aep/artanis-light/README.md

vehicle gps tracker with battery
================================

- cpu:     ESP32
- modem:   Quectel BG96 minipcie
- supply:  ~12V from vehicle
- battery: 2 14500 lifepo cells at 6.4V
