aep/artanis-light/basic.ods

Id | Designator | Package | Quantity | Designation | Supplier and ref | Stocked/Ordered
17 | C | C_0603_1608Metric | 2 | 0.1uF |  | S
24 | C | C_0402_1005Metric | 1 | 0.5pF. NP0, ±10 % |  | O
23 | C | C_0402_1005Metric | 1 | 0.8pF, NP0, ±10 % |  | O
50 | C | 603 | 1 | 100nF |  | S
11 | C | 603 | 5 | 100nF 50V |  | S
30 | C | C_0603_1608Metric | 4 | 100nF, X7R, ±10 % |  | S
31 | C | C_0603_1608Metric | 1 | 100pF, NP0, ±5 % |  | O
4 | C | CP_Elec_6.3x7.7 | 2 | 100uF 50V |  | S
29 | C | C_0603_1608Metric | 2 | 1.0uF, X7R, ±10 % |  | S
16 | C | 603 | 2 | 12pF, NP0, ±2% |  | S
53 | C | 603 | 1 | 2.2uF 50V |  | S
51 | C | 603 | 3 | 33pF |  | O
52 | C | C_0603_1608Metric | 2 | 33pf |  | O
37 | C | C_0603_1608Metric | 1 | 4.7uF |  | S
5 | C | 603 | 2 | 4.7uF 50V |  | S
32 | C | C_0603_1608Metric | 1 | 4.7uF, X7R, ±10 % |  | S
33 | C | C_0603_1608Metric | 4 | 56pf |  | O
28 | C | C_0603_1608Metric | 1 | 820pF, NP0, ±5 % |  | O
22 | C | C_0603_1608Metric | 2 | NC |  | /
25 | C | C_0402_1005Metric | 1 | NC |  | /
2 | CON1 | MM60-52B1-G1-R850 | 1 | MSATA-PCIE_MINI-CARD-MM60-52B1-G1-R850(Digi-Key_PN_670-2516-2-ND) |  | S
15 | D1 | LED_0603_1608Metric | 1 | APGA1602QBC/KA-5MAV |  | o
40 | D2 | D_SMB | 1 | SMBJ16CA-13-F |  | S
56 | D3 | SOT-23 | 1 | SZNUP2105L |  | S
14 | D4 | LED_0603_1608Metric | 1 | APGA1602CGC/KA |  | o
41 | EXT_ANT2,EXT_ANT1,EXT_ANT6 | SMA_Amphenol_132203-12_Horizontal | 3 | SMA_F_R_A_PCB |  | o
60 | EXT_ANT4,EXT_ANT3 | U.FL_Molex_MCRF_73412-0110_Vertical | 2 | SMA_F_R_A_PCB |  | S
38 | F1,F2 | Fuse_1206_3216Metric | 2 | Fuse |  | S
54 | FID2,FID1 | FIDUCIAL-1X2 | 2 | Fiducial |  | /
39 | FL1 | ACM70V | 1 | ACM70V-701-2PL-TL00 |  | S
49 | J1 | TC2030-MCP-NL | 1 | SWD |  | /
59 | J2 | nanosim-Wurth-693043020611 | 1 | simcard |  | S
3 | J3 | DF65-3P-1.7V | 1 | Conn_01x03_Male |  | O
44 | J5 | Molex_Micro-Fit_3.0_43045-0400_2x02_P3.00mm_Horizontal | 1 | Conn_02x02_Top_Bottom |  | o
27 | L1 | L_0402_1005Metric | 1 | 4.7nH ±5 % |  | o
42 | L2 | PE-1210ACC | 1 | PE-1210ACC110STS 11UH |  | S
6 | L3 | L_Coilcraft_XxL4020 | 1 | 2.2uH |  | o
19 | Q2 | SOT23-3 | 1 | PMV30XPEAR |  | o
21 | Q4 | SOT-23 | 1 | DMP3099L-7 |  | o
20 | R11 | R_0603_1608Metric | 1 | 10K |  | S
9 | R12 | 603 | 1 | 10K |  | S
8 | R14,R13 | 603 | 2 | 1K |  | S
35 | R24 | 603 | 1 | 16K + 22K + 5K |  | o
48 | R25 | 603 | 1 | 3k6 |  | S
58 | R3 | R_0603_1608Metric | 1 | 1K-10K |  | S
57 | R4,R1 | 603 | 2 | 3k6 |  | S
36 | R7,R6,R5 | 603 | 3 | 45 |  | S
13 | R8,R2,R10 | R_0603_1608Metric | 3 | 1K |  | S
10 | R9 | 603 | 1 | 33K2 1% |  | o
47 | TP2 | TP_SMD | 1 | L0 |  | /
46 | TP3 | TP_SMD | 1 | L1 |  | /
45 | TP4 | TP_SMD | 1 | L3 |  | /
18 | U1 | Nordic_AQFN-73-1EP_7x7mm_P0.5mm | 1 | nRF52840 |  | o
55 | U2 | QFN-20-1EP_4x4mm_P0.5mm_EP2.5x2.5mm_ThermalVias | 1 | MCP2515-QFN |  | S
7 | U3 | DFN-10-1EP_3x3mm_P0.5mm_EP1.55x2.48mm | 1 | MCP73223-C2S |  | o
43 | U4 | SOT-23-8 | 1 | TCAN332 |  | S
12 | U5 | SOT-23-6 | 1 | TPS565201DDC |  | o
1 | U7 | QFN-16 | 1 | MMA8452Q |  | S
26 | Y1 | Crystal_SMD_Abracon_ABM8G-4Pin_3.2x2.5mm | 1 | / |  | o
34 | Y2 | Crystal_SMD_Abracon_ABM8G-4Pin_3.2x2.5mm | 1 | M8AIG-16-12-2T3 |  | S
 |  |  |  | bg96
 |  |  |  | case
 |  |  |  | sma2sma
