aep/artanis-light/Model/battery_holder.step

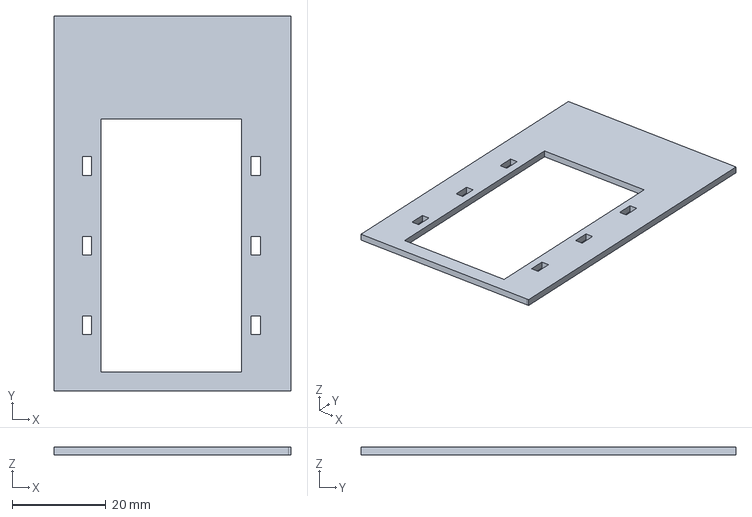
[picture p1: CAD file, 2021-03-20]
Model/battery_holder.step
50.5 x 80.0 x 1.60 mm
