aep/artanis-light/specs/Enclosure_AL-053-10.pdf

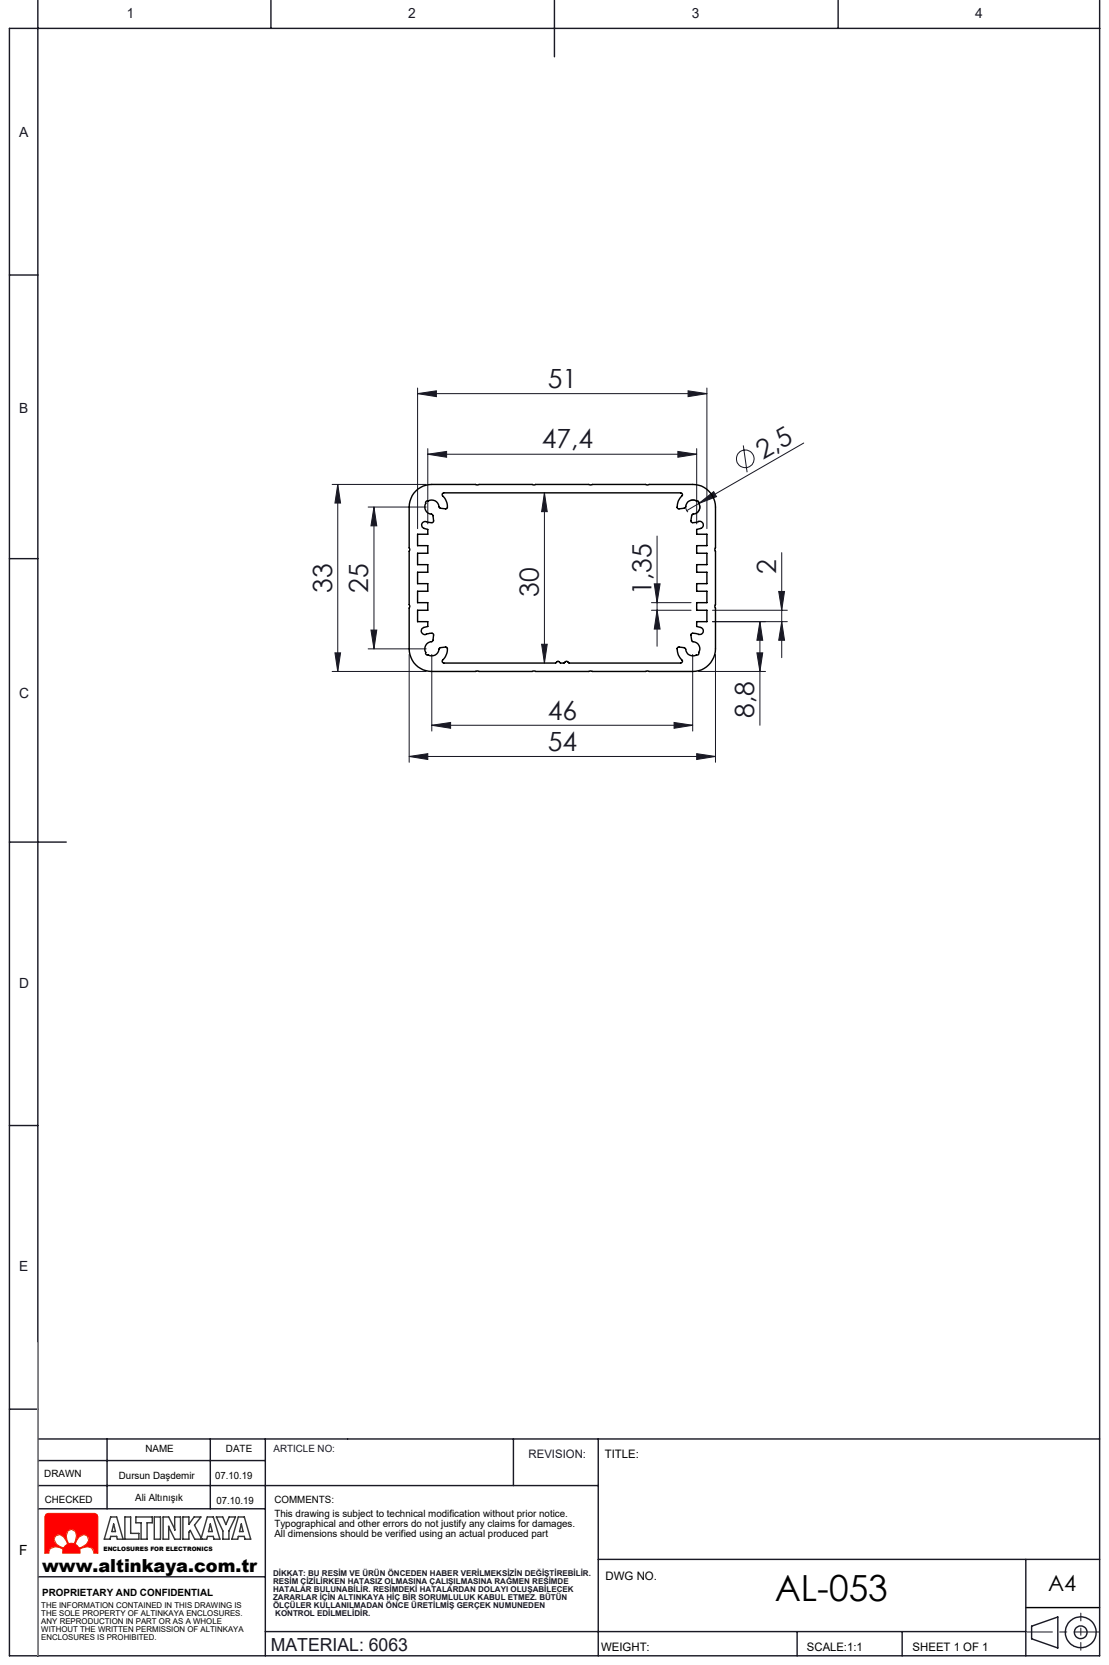
[picture p2: page 1]
SCALE:1:1; SHEET 1 OF 1; DWG NO.; Ali Altınışık; Dursun Daşdemir; NAME; DATE; ARTICLE NO:; REVISION:

This drawing is subject to technical modification without prior notice.
Typographical and other errors do not justify any claims for damages.
All dimensions should be verified using an actual produced part

www.altinkaya.com.tr

ENCLOSURES FOR ELECTRONICS

DİKKAT: BU RESİM VE ÜRÜN ÖNCEDEN HABER VERİLMEKSİZİN DEĞİŞTİREBİLİR.
RESİM ÇİZİLİRKEN HATASIZ OLMASINA ÇALIŞILMASINA RAĞMEN RESİMDE
HATALAR BULUNABİLİR. RESİMDEKİ HATALARDAN DOLAYI OLUŞABİLECEK
ZARARLAR İÇİN ALTINKAYA HİÇ BİR SORUMLULUK KABUL ETMEZ. BÜTÜN
ÖLÇÜLER KULLANILMADAN ÖNCE ÜRETİLMİŞ GERÇEK NUMUNEDEN
KONTROL EDİLMELİDİR.
MATERIAL: 6063

PROPRIETARY AND CONFIDENTIAL
THE INFORMATION CONTAINED IN THIS DRAWING IS
THE SOLE PROPERTY OF ALTINKAYA ENCLOSURES.
ANY REPRODUCTION IN PART OR AS A WHOLE
WITHOUT THE WRITTEN PERMISSION OF ALTINKAYA
ENCLOSURES IS PROHIBITED.
