aep/artanis-light/basic.kicad_pcb

## KiCad design basic.kicad_pcb (2021-03-20)

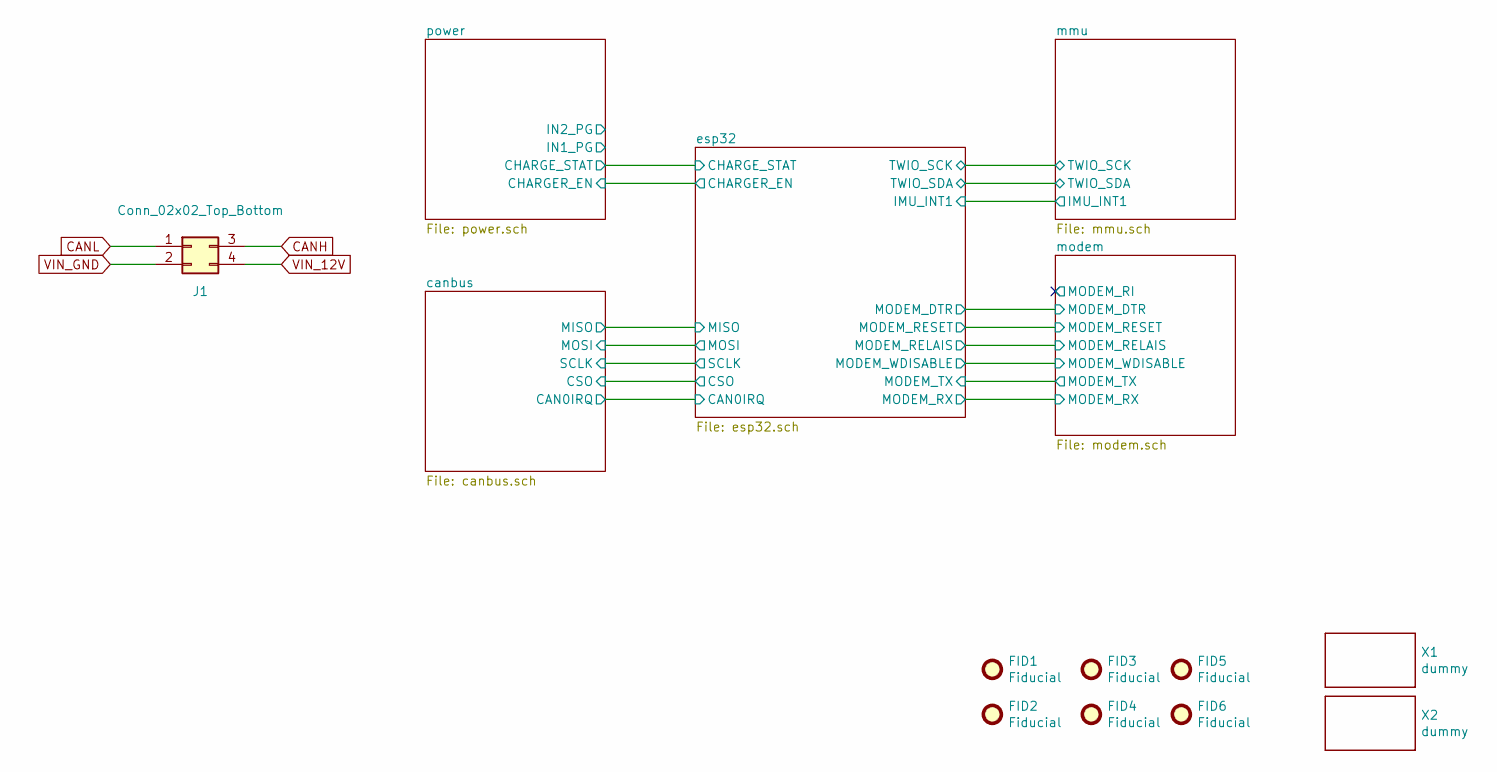
[picture p3: schematic basic.sch]

Parts:
FID1, FID2, FID3, FID4, FID5, FID6: Fiducial; FIDUCIAL-1X2
J1: Conn_02x02_Top_Bottom; Molex_Micro-Fit_3.0_43045-0400_2x02_P3.00mm_Horizontal
X1: dummy; WEEE-Logo_2.1x3mm_SilkScreen
X2: dummy; OSHW-LOGO-S

Connections:
CANH: J1.3; also elsewhere on the board
CANL: J1.1; also elsewhere on the board
VIN_12V: J1.4; also elsewhere on the board
VIN_GND: J1.2; also elsewhere on the board

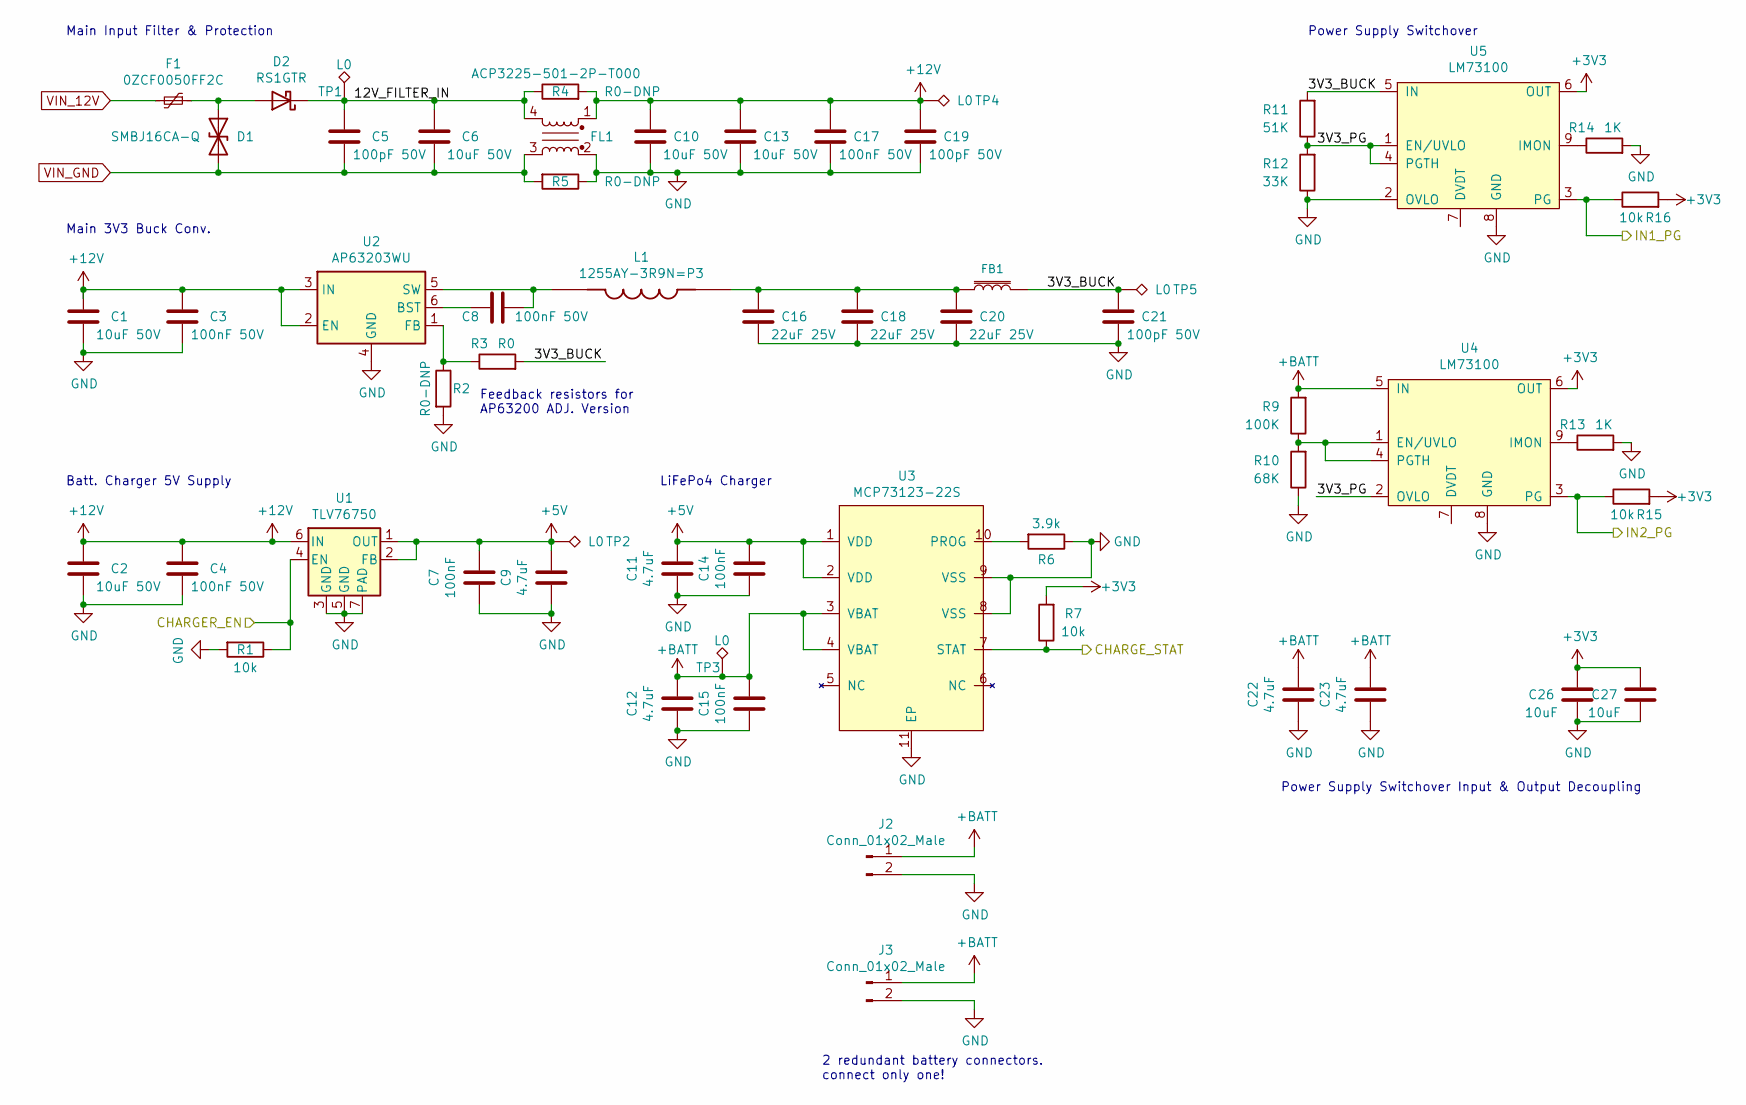
[picture p4: schematic power.sch]

Parts:
C1, C2, C6, C10, C13: 10uF 50V; C_0805_2012Metric
C3, C4, C8, C17: 100nF 50V; C_0603_1608Metric
C5, C19, C21: 100pF 50V; C_0603_1608Metric
C7, C14, C15: 100nF; C_0603_1608Metric
C9, C11, C12, C22, C23: 4.7uF; C_0603_1608Metric
C16, C18, C20: 22uF 25V; C_0805_2012Metric
C26, C27: 10uF; C_0603_1608Metric
D1: SMBJ16CA-Q; D_SMB
D2: RS1GTR; D_SMA
F1: 0ZCF0050FF2C; Fuse_2920_7451Metric_Castellated
FB1: BLM18PG181SN1D; 0603
FL1: ACP3225-501-2P-T000; ACP3225
J2: Conn_01x02_Male; JST_SH_BM02B-SRSS-TB_1x02-1MP_P1.00mm_Vertical
J3: Conn_01x02_Male; JST_SH_SM02B-SRSS-TB_1x02-1MP_P1.00mm_Horizontal
L1: 1255AY-3R9N=P3; IND_1255AY-3R9N=P3
R1, R7, R15, R16: 10k; R_0603_1608Metric
R2, R4, R5: R0-DNP; R_0603_1608Metric
R3: R0; R_0603_1608Metric
R6: 3.9k; R_0603_1608Metric
R9: 100K; R_0603_1608Metric
R10: 68K; R_0603_1608Metric
R11: 51K; R_0603_1608Metric
R12: 33K; R_0603_1608Metric
R13, R14: 1K; R_0603_1608Metric
TP1, TP2, TP3, TP4, TP5: L0; TestPoint_Pad_D1.0mm
U1: TLV76750; WSON-6-1EP_2x2mm_P0.65mm_EP1x1.6mm_ThermalVias
U2: AP63203WU; TSOT-23-6
U3: MCP73123-22S; DFN-10-1EP_3x3mm_P0.5mm_EP1.55x2.48mm
U4, U5: LM73100

Connections:
+3V3: C26.1, C27.1, R7.2, R15.2, R16.2, U4.6 (OUT), U5.6 (OUT); also elsewhere on the board
+5V: C7.1, C9.1, C11.1, C14.1, TP2.1, U1.1 (OUT), U1.2 (FB), U3.1 (VDD), U3.2 (VDD)
+12V: C1.2, C2.2, C3.2, C4.2, C10.2, C13.2, C17.2, C19.2, FL1.1, R4.2, TP4.1, U1.6 (IN), U2.2 (EN), U2.3 (IN); also elsewhere on the board
+BATT: C12.1, C15.1, C22.1, C23.1, J2.1, J3.1, R9.2, TP3.1, U3.3 (VBAT), U3.4 (VBAT), U4.5 (IN); also elsewhere on the board
/esp32/CHARGER_EN: R1.1, U1.4 (EN); also elsewhere on the board
/esp32/CHARGE_STAT: R7.1, U3.7 (STAT); also elsewhere on the board
/power/3V3_BUCK: C21.2, FB1.2, R3.2, R11.2, TP5.1, U5.5 (IN)
/power/3V3_PG: R11.1, R12.2, U4.2 (OVLO), U5.1 (EN/UVLO), U5.4 (PGTH)
/power/12V_FILTER_IN: C5.2, C6.2, D2.1 (K), FL1.4, R4.1, TP1.1
/power/IN1_PG: R16.1, U5.3 (PG)
/power/IN2_PG: R15.1, U4.3 (PG)
GND: C1.1, C2.1, C3.1, C4.1, C7.2, C9.2, C10.1, C11.2, C12.2, C13.1, C14.2, C15.2, C16.1, C17.1, C18.1, C19.1, C20.1, C21.1, C22.2, C23.2, C26.2, C27.2, FL1.2, J2.2, J3.2, R1.2, R2.2, R5.1, R6.1, R10.1, R12.1, R13.2, R14.2, U1.3 (GND), U1.5 (GND), U1.7 (PAD), U2.4 (GND), U3.8 (VSS), U3.9 (VSS), U3.11 (EP), U4.8 (GND), U5.2 (OVLO), U5.8 (GND); also elsewhere on the board
unnamed: C8.1, L1.1, U2.5 (SW)
unnamed: C8.2, U2.6 (BST)
unnamed: C16.2, C18.2, C20.2, FB1.1, L1.2
unnamed: D1.1 (A1), D2.2 (A), F1.1
unnamed: R2.1, R3.1, U2.1 (FB)
unnamed: R6.2, U3.10 (PROG)
unnamed: R9.1, R10.2, U4.1 (EN/UVLO), U4.4 (PGTH)
unnamed: R13.1, U4.9 (IMON)
unnamed: R14.1, U5.9 (IMON)
VIN_12V: F1.2; also elsewhere on the board
VIN_GND: C5.1, C6.1, D1.2 (A2), FL1.3, R5.2; also elsewhere on the board

Notes on the sheet:
Feedback resistors for AP63200 ADJ. Version
2 redundant battery connectors. connect only one!
Power Supply Switchover
Batt. Charger 5V Supply
LiFePo4 Charger
Main 3V3 Buck Conv.
Main Input Filter & Protection
Power Supply Switchover Input & Output Decoupling

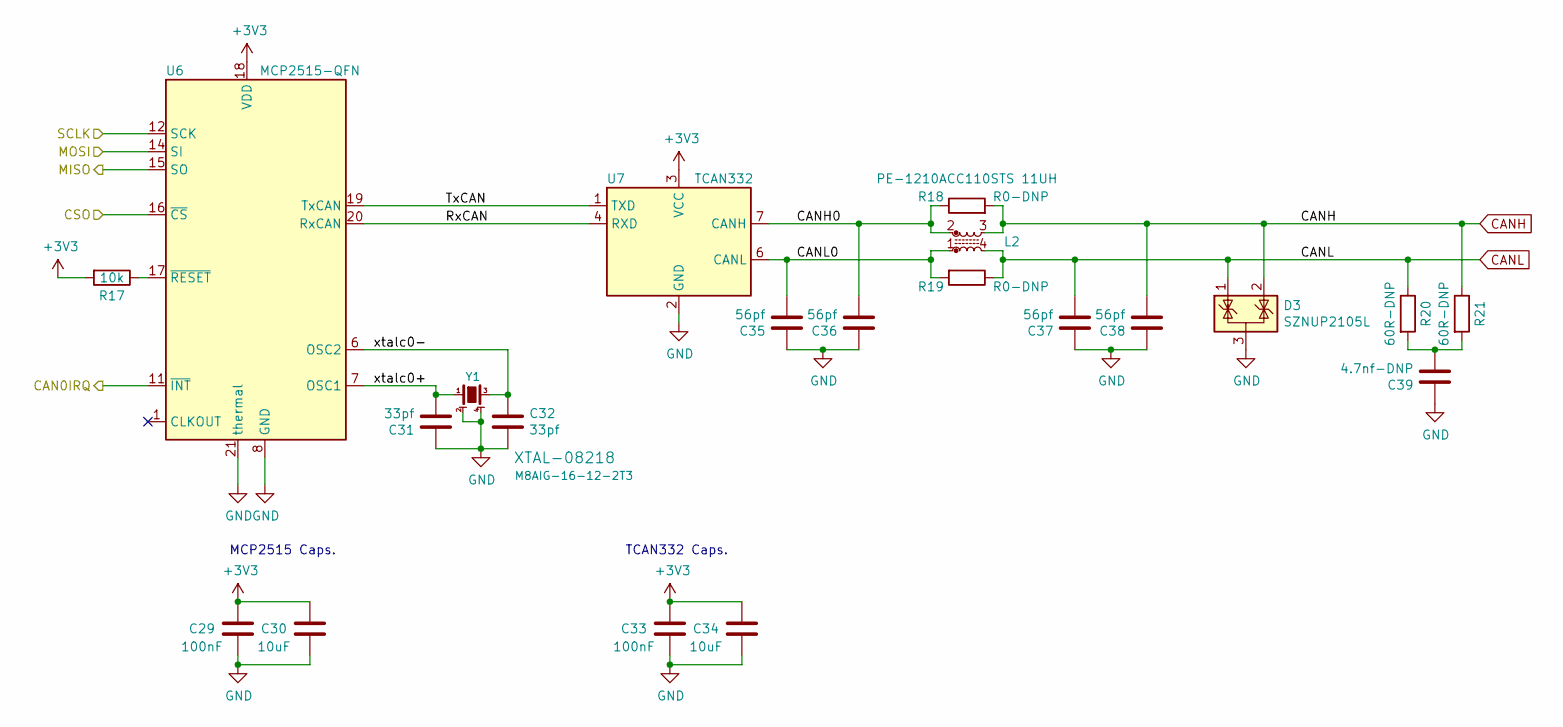
[picture p5: schematic canbus.sch]

Parts:
C29, C33: 100nF; C_0603_1608Metric
C30, C34: 10uF; C_0603_1608Metric
C31, C32: 33pf; C_0603_1608Metric
C35, C36, C37, C38: 56pf; C_0603_1608Metric
C39: 4.7nf-DNP; C_0603_1608Metric
D3: SZNUP2105L; SOT-23
L2: PE-1210ACC110STS 11UH; PE-1210ACC
R17: 10k; R_0603_1608Metric
R18, R19: R0-DNP; R_0603_1608Metric
R20, R21: 60R-DNP; R_0603_1608Metric
U6: MCP2515-QFN; QFN-20-1EP_4x4mm_P0.5mm_EP2.5x2.5mm_ThermalVias
U7: TCAN332; SOT-23-8
Y1: M8AIG-16-12-2T3; Crystal_SMD_Abracon_ABM8G-4Pin_3.2x2.5mm

Connections:
+3V3: C29.1, C30.1, C33.1, C34.1, R17.2, U6.18 (VDD), U7.3 (VCC); also elsewhere on the board
/canbus/CAN0IRQ: U6.11 (~INT); also elsewhere on the board
/canbus/CANH0: C36.2, L2.2, R18.1, U7.7 (CANH)
/canbus/CANL0: C35.2, L2.1, R19.2, U7.6 (CANL)
/canbus/CSO: U6.16 (~CS); also elsewhere on the board
/canbus/MISO: U6.15 (SO); also elsewhere on the board
/canbus/MOSI: U6.14 (SI); also elsewhere on the board
/canbus/RxCAN: U6.20 (RxCAN), U7.4 (RXD)
/canbus/SCLK: U6.12 (SCK); also elsewhere on the board
/canbus/TxCAN: U6.19 (TxCAN), U7.1 (TXD)
/canbus/xtalc0+: C31.2, U6.7 (OSC1), Y1.1
/canbus/xtalc0-: C32.1, U6.6 (OSC2), Y1.3
CANH: C38.2, D3.2 (K), L2.3, R18.2, R21.1; also elsewhere on the board
CANL: C37.2, D3.1 (K), L2.4, R19.1, R20.1; also elsewhere on the board
GND: C29.2, C30.2, C31.1, C32.2, C33.2, C34.2, C35.1, C36.1, C37.1, C38.1, C39.1, D3.3 (A), U6.8 (GND), U6.21 (thermal), U7.2 (GND), Y1.2, Y1.4; also elsewhere on the board
unnamed: C39.2, R20.2, R21.2
unnamed: R17.1, U6.17 (~RESET)

Notes on the sheet:
MCP2515 Caps.
TCAN332 Caps.

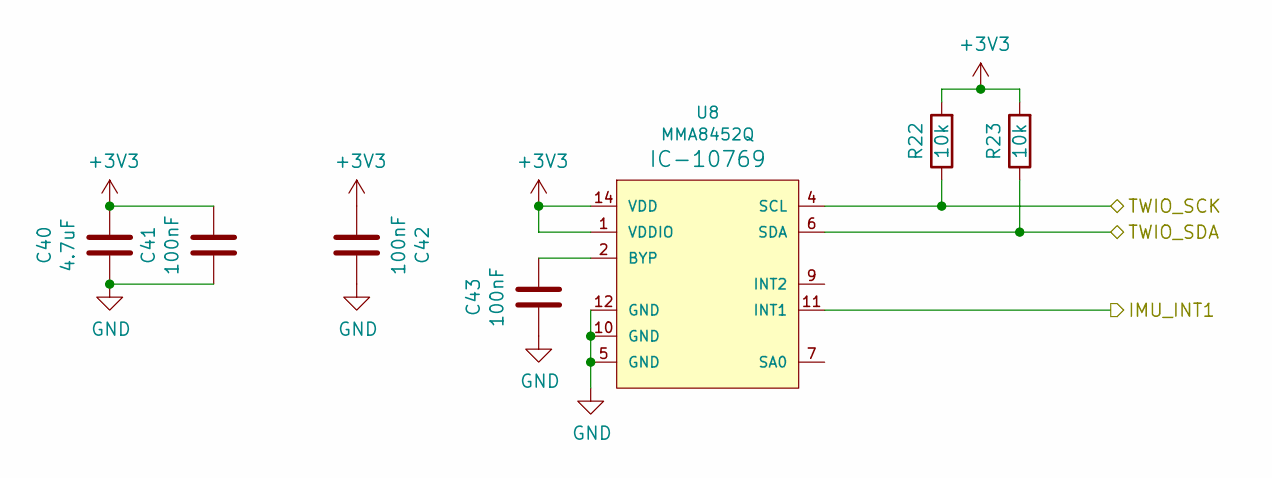
[picture p6: schematic mmu.sch]

Parts:
C40: 4.7uF; C_0603_1608Metric
C41, C42, C43: 100nF; C_0603_1608Metric
R22, R23: 10k; R_0603_1608Metric
U8: MMA8452Q; QFN-16

Connections:
+3V3: C40.1, C41.1, C42.2, R22.2, R23.2, U8.1 (VDDIO), U8.14 (VDD); also elsewhere on the board
/esp32/IMU_INT1: U8.11 (INT1); also elsewhere on the board
/esp32/TWIO_SCK: R22.1, U8.4 (SCL); also elsewhere on the board
/esp32/TWIO_SDA: R23.1, U8.6 (SDA); also elsewhere on the board
GND: C40.2, C41.2, C42.1, C43.2, U8.5 (GND), U8.10 (GND), U8.12 (GND); also elsewhere on the board
unnamed: C43.1, U8.2 (BYP)

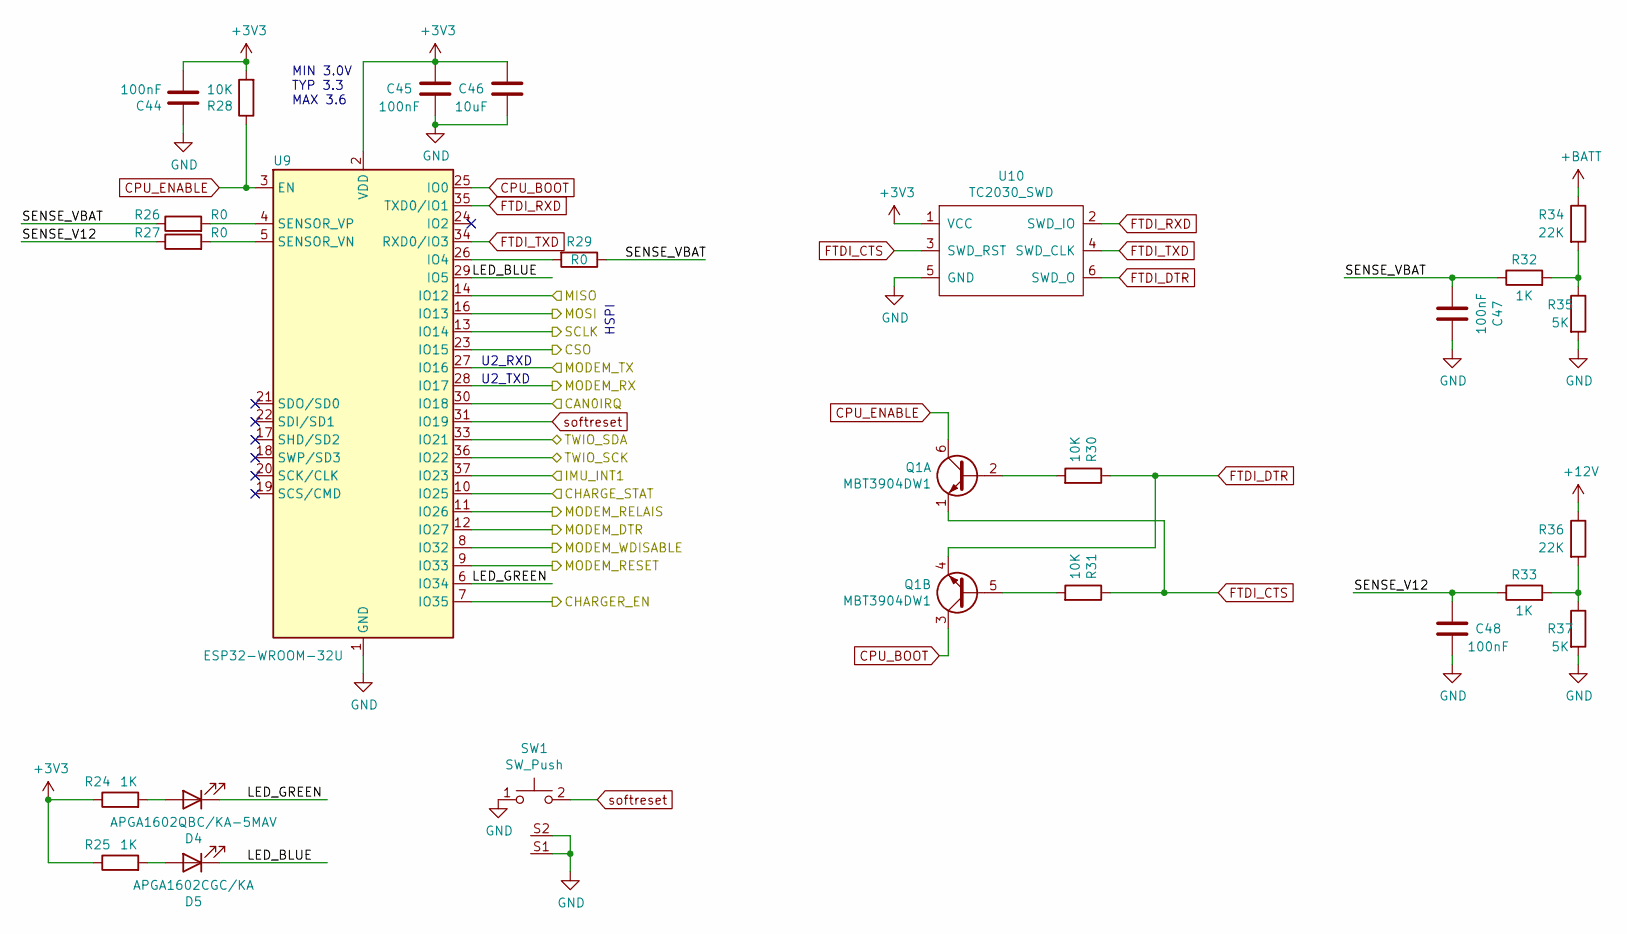
[picture p7: schematic esp32.sch]

Parts:
C44: 100nF; 0603
C45, C47, C48: 100nF; C_0603_1608Metric
C46: 10uF; C_0603_1608Metric
D4: APGA1602QBC/KA-5MAV; LED_0603_1608Metric
D5: APGA1602CGC/KA; LED_0603_1608Metric
Q1: MBT3904DW1; SOT-363_SC-70-6
R24, R25, R32, R33: 1K; R_0603_1608Metric
R26, R27, R29: R0; R_0603_1608Metric
R28, R30, R31: 10K; R_0603_1608Metric
R34, R36: 22K; R_0603_1608Metric
R35, R37: 5K; R_0603_1608Metric
SW1: SW_Push; SW_1825027-5
U9: ESP32-WROOM-32U
U10: TC2030_SWD; Tag-Connect_TC2030-IDC-FP_2x03_P1.27mm_Vertical

Connections:
+3V3: C44.2, C45.1, C46.1, R24.1, R25.1, R28.2, U9.2 (VDD), U10.1 (VCC); also elsewhere on the board
+12V: R36.1; also elsewhere on the board
+BATT: R34.1; also elsewhere on the board
/canbus/CAN0IRQ: U9.30 (IO18); also elsewhere on the board
/canbus/CSO: U9.23 (IO15); also elsewhere on the board
/canbus/MISO: U9.14 (IO12); also elsewhere on the board
/canbus/MOSI: U9.16 (IO13); also elsewhere on the board
/canbus/SCLK: U9.13 (IO14); also elsewhere on the board
/esp32/CHARGER_EN: U9.7 (IO35); also elsewhere on the board
/esp32/CHARGE_STAT: U9.10 (IO25); also elsewhere on the board
/esp32/IMU_INT1: U9.37 (IO23); also elsewhere on the board
/esp32/LED_BLUE: D5.1 (K), U9.29 (IO5)
/esp32/LED_GREEN: D4.1 (K), U9.6 (IO34)
/esp32/MODEM_DTR: U9.12 (IO27); also elsewhere on the board
/esp32/MODEM_RELAIS: U9.11 (IO26); also elsewhere on the board
/esp32/MODEM_RESET: U9.9 (IO33); also elsewhere on the board
/esp32/MODEM_RX: U9.28 (IO17); also elsewhere on the board
/esp32/MODEM_TX: U9.27 (IO16); also elsewhere on the board
/esp32/MODEM_WDISABLE: U9.8 (IO32); also elsewhere on the board
/esp32/SENSE_V12: C48.2, R27.1, R33.1
/esp32/SENSE_VBAT: C47.2, R26.1, R29.1, R32.1
/esp32/TWIO_SCK: U9.36 (IO22); also elsewhere on the board
/esp32/TWIO_SDA: U9.33 (IO21); also elsewhere on the board
CPU_BOOT: Q1.3 (C2), U9.25 (IO0)
CPU_ENABLE: Q1.6 (C1), R28.1, U9.3 (EN)
FTDI_CTS: Q1.1 (E1), R31.1, U10.3 (SWD_RST)
FTDI_DTR: Q1.4 (E2), R30.1, U10.6 (SWD_O)
FTDI_RXD: U9.35 (TXD0/IO1), U10.2 (SWD_IO)
FTDI_TXD: U9.34 (RXD0/IO3), U10.4 (SWD_CLK)
GND: C44.1, C45.2, C46.2, C47.1, C48.1, R35.2, R37.2, SW1.1, SW1.S1 (Shield1), SW1.S2 (Shield2), U9.1 (GND), U9.15 (GND), U9.38 (GND), U9.39 (GND), U10.5 (GND); also elsewhere on the board
unnamed: D4.2 (A), R24.2
unnamed: D5.2 (A), R25.2
unnamed: Q1.2 (B1), R30.2
unnamed: Q1.5 (B2), R31.2
unnamed: R26.2, U9.4 (SENSOR_VP)
unnamed: R27.2, U9.5 (SENSOR_VN)
unnamed: R29.2, U9.26 (IO4)
unnamed: R32.2, R34.2, R35.1
unnamed: R33.2, R36.2, R37.1
softreset: SW1.2, U9.31 (IO19)

Notes on the sheet:
MIN 3.0V TYP 3.3 MAX 3.6
HSPI
U2_RXD
U2_TXD

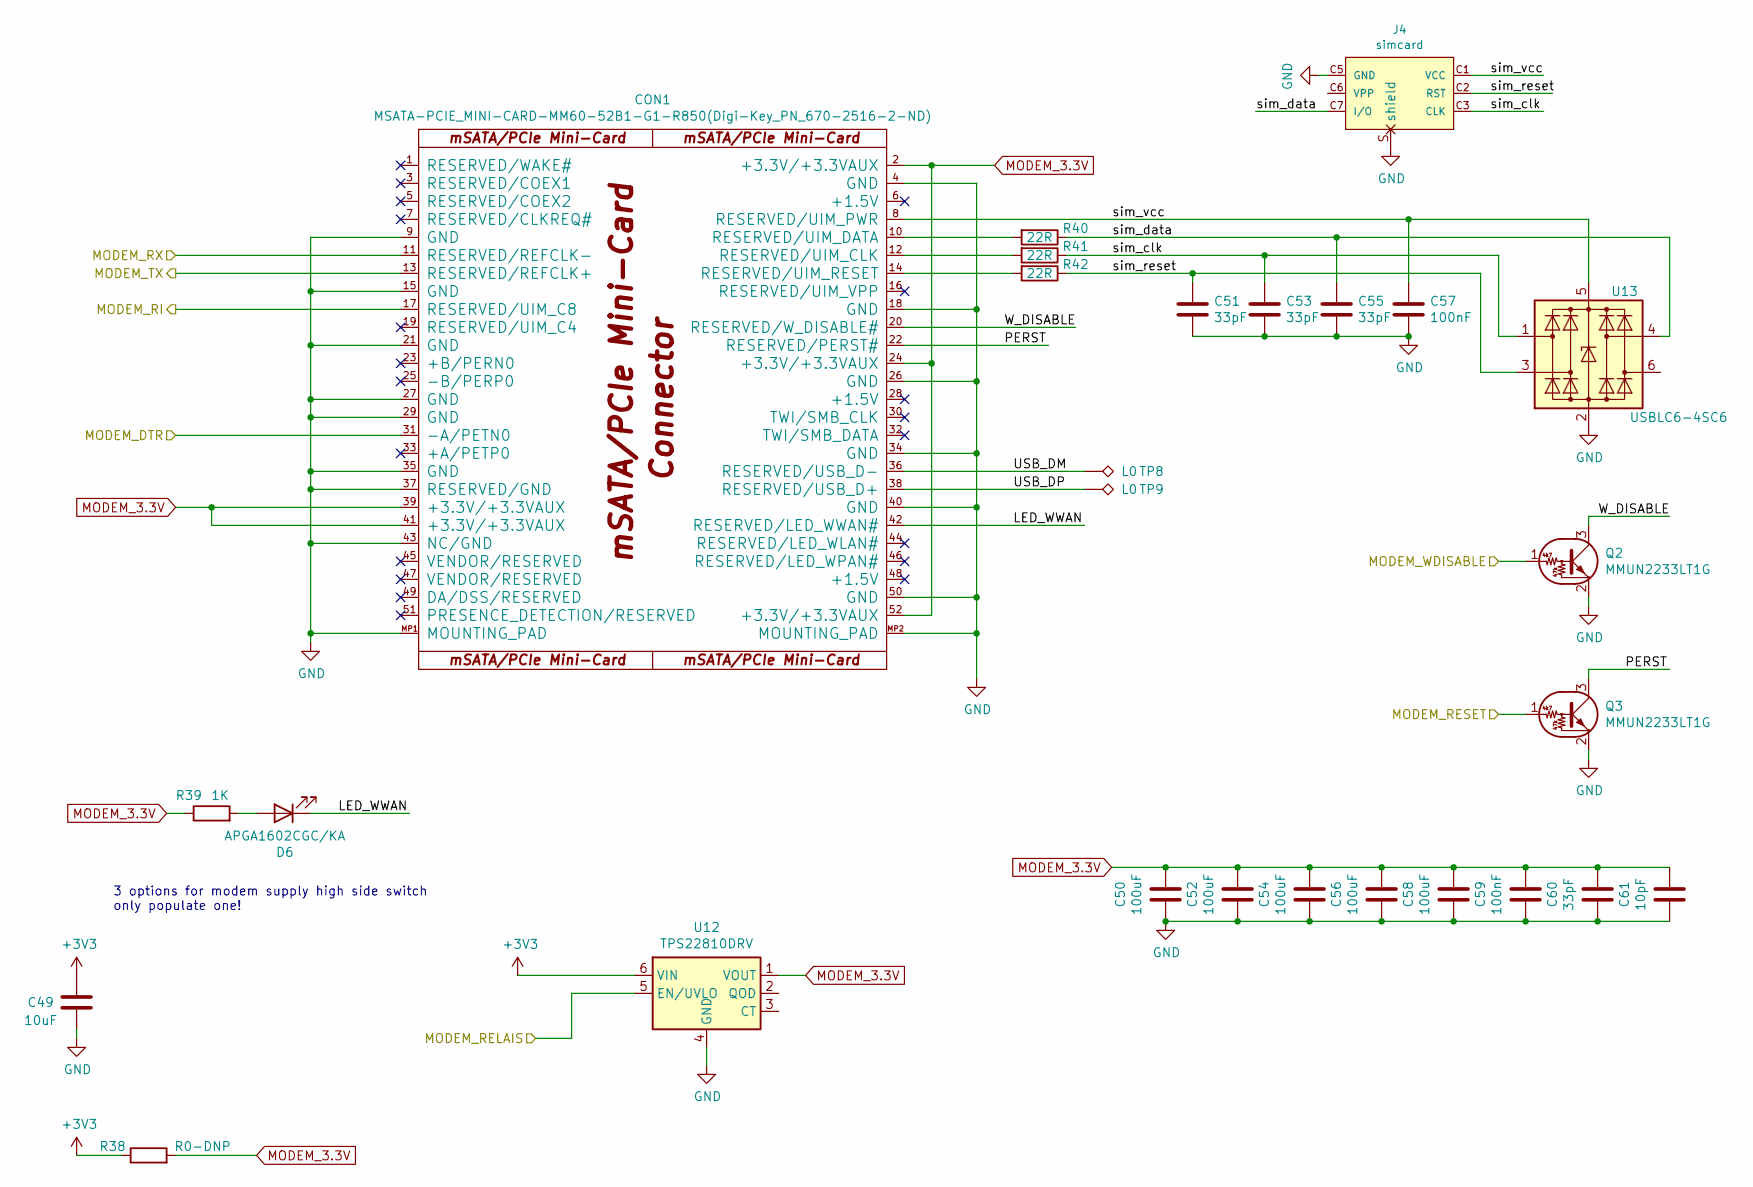
[picture p8: schematic modem.sch]

Parts:
C49: 10uF; C_0603_1608Metric
C50, C52, C54, C56, C58: 100uF; C_1206_3216Metric
C51, C53, C55, C60: 33pF; C_0603_1608Metric
C57, C59: 100nF; C_0603_1608Metric
C61: 10pF; C_0603_1608Metric
CON1: MSATA-PCIE_MINI-CARD-MM60-52B1-G1-R850(Digi-Key_P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; MM60-52B1-G1-R850
D6: APGA1602CGC/KA; LED_0603_1608Metric
J4: simcard; nanosim-Wurth-693043020611
Q2, Q3: MMUN2233LT1G; SOT-23
R38: R0-DNP; R_0603_1608Metric
R39: 1K; R_0603_1608Metric
R40, R41, R42: 22R; R_0603_1608Metric
TP8, TP9: L0; TestPoint_Pad_D1.0mm
U12: TPS22810DRV; WSON-6-1EP_2x2mm_P0.65mm_EP1x1.6mm
U13: USBLC6-4SC6; SOT-23-6

Connections:
+3V3: C49.1, R38.1, U12.6 (VIN); also elsewhere on the board
/esp32/MODEM_DTR: CON1.31 (-A/PETN0); also elsewhere on the board
/esp32/MODEM_RELAIS: U12.5 (EN/UVLO); also elsewhere on the board
/esp32/MODEM_RESET: Q3.1 (B); also elsewhere on the board
/esp32/MODEM_RX: CON1.11 (RESERVED/REFCLK-); also elsewhere on the board
/esp32/MODEM_TX: CON1.13 (RESERVED/REFCLK+); also elsewhere on the board
/esp32/MODEM_WDISABLE: Q2.1 (B); also elsewhere on the board
/modem/LED_WWAN: CON1.42 (RESERVED/LED_WWAN#), D6.1 (K)
/modem/MODEM_RI: CON1.17 (RESERVED/UIM_C8)
/modem/PERST: CON1.22 (RESERVED/PERST#), Q3.3 (C)
/modem/USB_DM: CON1.36 (RESERVED/USB_D-), TP8.1
/modem/USB_DP: CON1.38 (RESERVED/USB_D+), TP9.1
/modem/W_DISABLE: CON1.20 (RESERVED/W_DISABLE#), Q2.3 (C)
/modem/sim_clk: C53.1, J4.C3 (CLK), R41.1, U13.1 (I/O1)
/modem/sim_data: C55.1, J4.C7 (I/O), R40.1, U13.4 (I/O3)
/modem/sim_reset: C51.1, J4.C2 (RST), R42.1, U13.3 (I/O2)
/modem/sim_vcc: C57.1, CON1.8 (RESERVED/UIM_PWR), J4.C1 (VCC), U13.5 (VBUS)
GND: C49.2, C50.2, C51.2, C52.2, C53.2, C54.2, C55.2, C56.2, C57.2, C58.2, C59.2, C60.2, C61.2, CON1.4 (GND), CON1.9 (GND), CON1.15 (GND), CON1.18 (GND), CON1.21 (GND), CON1.26 (GND), CON1.27 (GND), CON1.29 (GND), CON1.34 (GND), CON1.35 (GND), CON1.37 (RESERVED/GND), CON1.40 (GND), CON1.43 (NC/GND), CON1.50 (GND), CON1.MP1 (MOUNTING_PAD), CON1.MP2 (MOUNTING_PAD), J4.C5 (GND), J4.S (shield), Q2.2 (E), Q3.2 (E), U12.4 (GND), U12.7 (GND), U13.2 (GND); also elsewhere on the board
MODEM_3.3V: C50.1, C52.1, C54.1, C56.1, C58.1, C59.1, C60.1, C61.1, CON1.2 (+3.3V/+3.3VAUX), CON1.24 (+3.3V/+3.3VAUX), CON1.39 (+3.3V/+3.3VAUX), CON1.41 (+3.3V/+3.3VAUX), CON1.52 (+3.3V/+3.3VAUX), R38.2, R39.1, U12.1 (VOUT)
unnamed: CON1.10 (RESERVED/UIM_DATA), R40.2
unnamed: CON1.12 (RESERVED/UIM_CLK), R41.2
unnamed: CON1.14 (RESERVED/UIM_RESET), R42.2
unnamed: D6.2 (A), R39.2

Notes on the sheet:
3 options for modem supply high side switch only populate one!

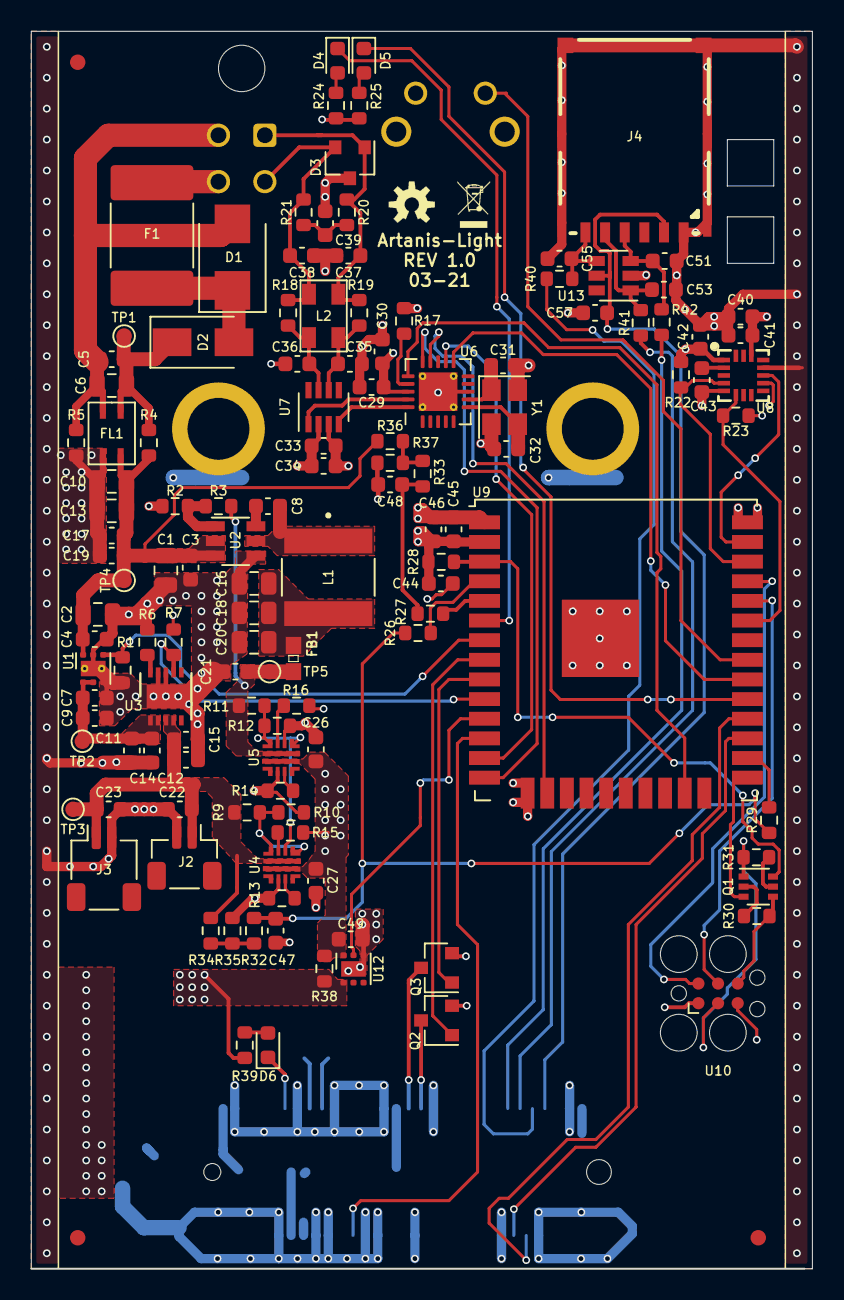
[picture p9: board basic.kicad_pcb from above]

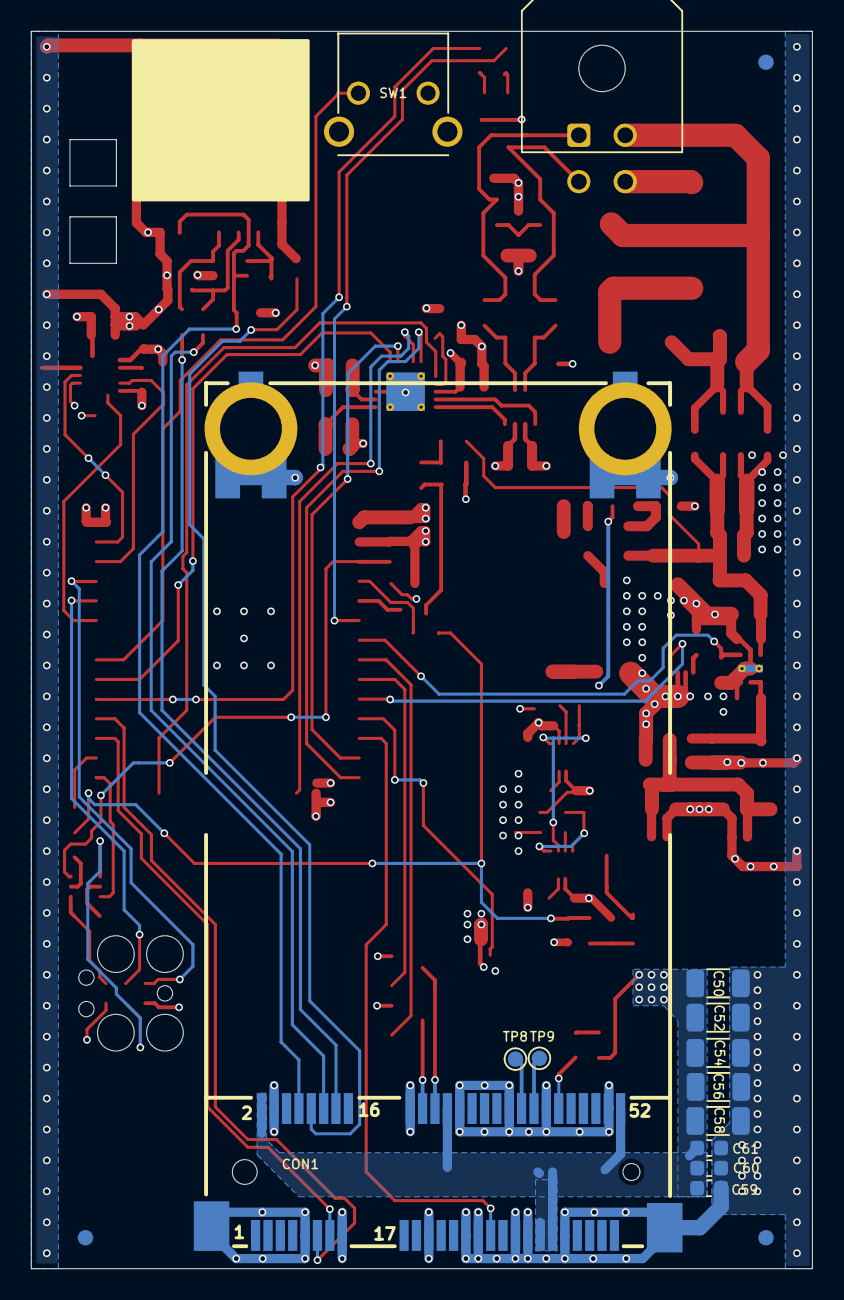
[picture p10: board basic.kicad_pcb from below]

Board: 4 copper layers, 50.5 x 80.0 mm, 147 parts (16 on the bottom side), 82 nets.
