aep/artanis-light/(commit log)

2021-02-27 MMU Schematic rework.
    [basic.sch, canbus.sch, esp32.sch, mmu.sch, modem.sch, power.sch]
2021-02-28 Esp32 & Canbus Sch. edited.
    [basic.sch, canbus.sch, esp32.sch, modem.sch, power.sch]
2021-02-28 Modem schematic updated.
    [basic.sch, esp32.sch, mmu.sch, modem.sch, power.sch]
2021-02-28 Power Sch. Updated.
    [basic.sch, canbus.sch, esp32.sch, mmu.sch, modem.sch, power.sch]
2021-03-01 Fixed Buck feedback reference.
    [power.sch]
2021-03-01 Added LM73100 to project library.
    [power.sch]
2021-03-02 Updated power mux with LM73100.
    [basic.sch, power.sch]
2021-03-06 Changed PTC Fuse.
    [power.sch]
2021-03-10 Power section placement completed.
    [basic.kicad_pcb, basic.sch, canbus.sch, esp32.sch, mmu.sch, modem.sch, power.sch]
2021-03-11 Power section routing completed.
    [basic.kicad_pcb, basic.sch, modem.sch, power.sch]
2021-03-17 PCB design updated.
    [basic.kicad_pcb, canbus.sch, mmu.sch, modem.sch]
2021-03-17 PCB Design completed.
    [basic.kicad_pcb]
2021-03-17 Fixed DRC Errors.
    [basic.kicad_pcb]
2021-03-18 Changed MCU connection.
    [basic.kicad_pcb, esp32.sch]
2021-03-20 Added cutout for antenna cable.
    [basic.kicad_pcb]
2021-03-20 Added battery holder PCB and Created 3D model for enclosure.
    [basic.kicad_pcb, battery_holder.kicad_pcb]
2021-03-20 Added 3D model and DXF for enclousure.
    [battery_holder.step]
